robotgtfxry/10.525-GHz-Radar/(list of files, drawings)

Other design files:
kicad/kicad/temp-freerouting.dsn
kicad/mux/temp-freerouting.dsn
