robotgtfxry/10.525-GHz-Radar/kicad/kicad/kicad.kicad_pcb

## KiCad design kicad/kicad/kicad.kicad_pcb (2026-08-19)

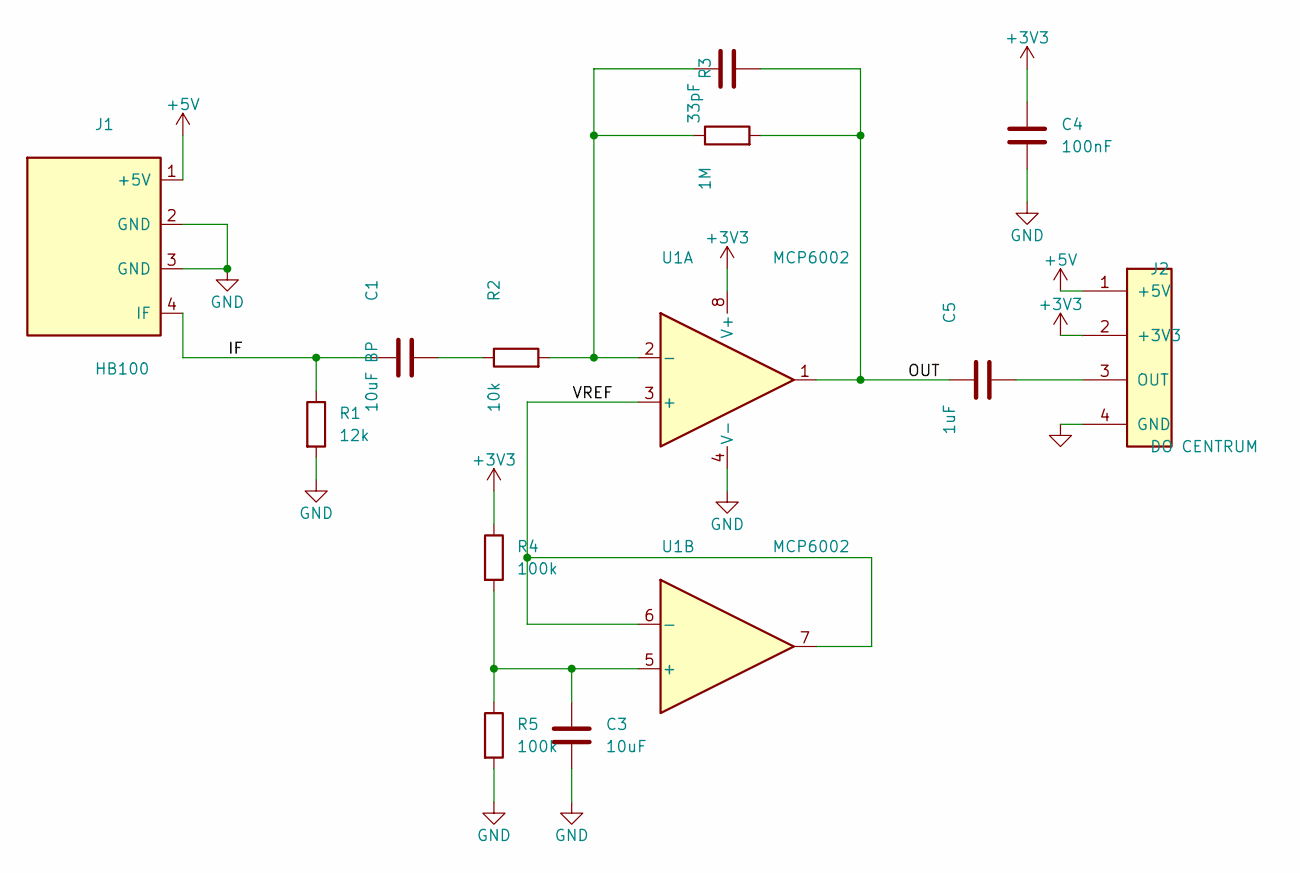
[picture p1: schematic kicad.kicad_sch]

Parts:
C1: 10uF BP; C_1210_3225Metric_Pad1.33x2.70mm_HandSolder
C2: 33pF; C_1206_3216Metric_Pad1.33x1.80mm_HandSolder
C3: 10uF; C_1210_3225Metric_Pad1.33x2.70mm_HandSolder
C4: 100nF; C_1206_3216Metric_Pad1.33x1.80mm_HandSolder
C5: 1uF; C_1206_3216Metric_Pad1.33x1.80mm_HandSolder
J1: HB100; HB100_Pads_4x_THT
J2: DO CENTRUM; JST_XH_B4B-XH-A_1x04_P2.50mm_Vertical
R1: 12k; R_1206_3216Metric_Pad1.30x1.75mm_HandSolder
R2: 10k; R_1206_3216Metric_Pad1.30x1.75mm_HandSolder
R3: 1M; R_1206_3216Metric_Pad1.30x1.75mm_HandSolder
R4, R5: 100k; R_1206_3216Metric_Pad1.30x1.75mm_HandSolder
U1: MCP6002; SOIC-8_3.9x4.9mm_P1.27mm

Connections:
+3V3: C4.1, J2.2 (+3V3), R4.1, U1.8 (V+)
+5V: J1.1 (+5V), J2.1 (+5V)
/IF: C1.1, J1.4 (IF), R1.1
/OUT: C2.2, C5.1, R3.2, U1.1
/VREF: U1.3 (+), U1.6 (-), U1.7
GND: C3.2, C4.2, J1.2 (GND), J1.3 (GND), J2.4 (GND), R1.2, R5.2, U1.4 (V-)
unnamed: C1.2, R2.1
unnamed: C5.2, J2.3 (OUT)
unnamed: C2.1, R2.2, R3.1, U1.2 (-)
unnamed: C3.1, R4.2, R5.1, U1.5 (+)

Board: 2 copper layers, 13 parts (0 on the bottom side), 10 nets, no tracks yet.
