robotgtfxry/10.525-GHz-Radar/kicad/mux/mux.kicad_pcb

## KiCad design kicad/mux/mux.kicad_pcb (2026-08-19)

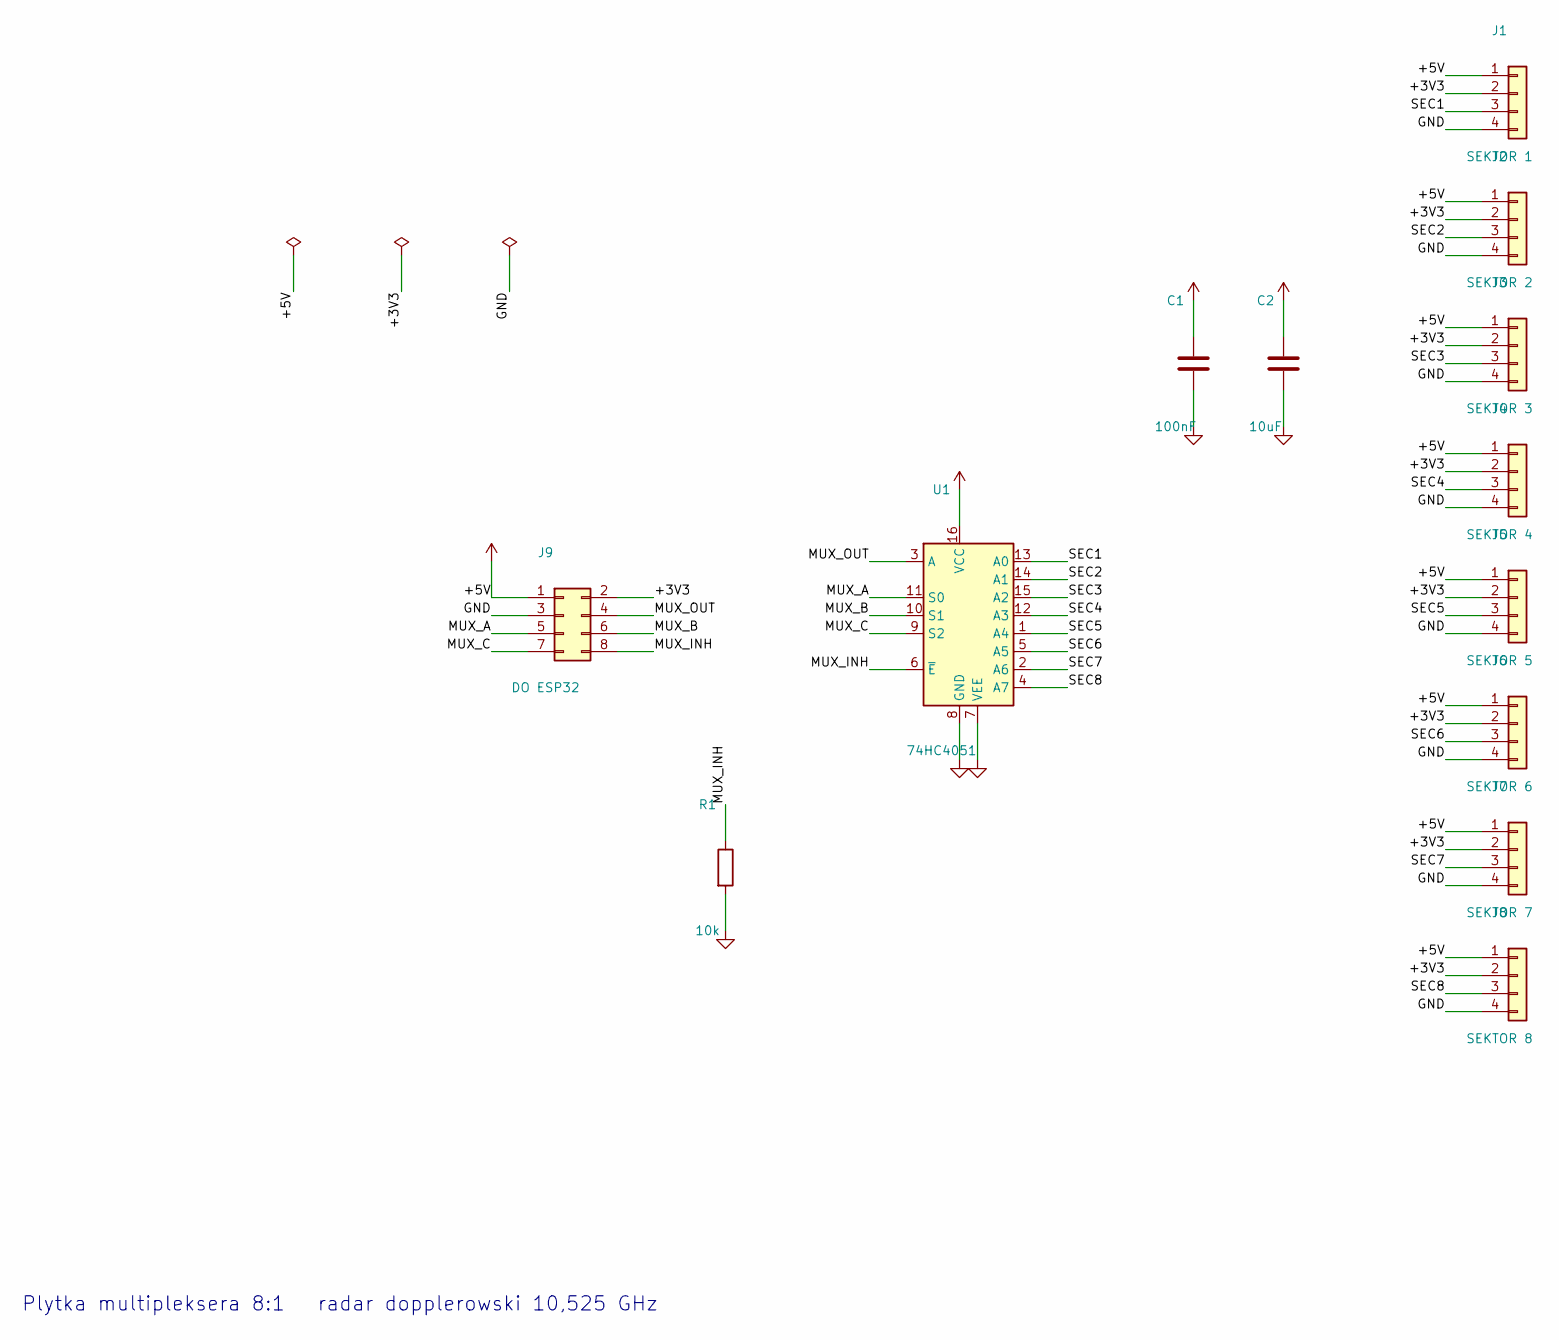
[picture p2: schematic mux.kicad_sch]

Parts:
C1: 100nF; C_1206_3216Metric_Pad1.33x1.80mm_HandSolder
C2: 10uF; C_1210_3225Metric_Pad1.33x2.70mm_HandSolder
J1: SEKTOR 1; JST_XH_B4B-XH-A_1x04_P2.50mm_Vertical
J2: SEKTOR 2; JST_XH_B4B-XH-A_1x04_P2.50mm_Vertical
J3: SEKTOR 3; JST_XH_B4B-XH-A_1x04_P2.50mm_Vertical
J4: SEKTOR 4; JST_XH_B4B-XH-A_1x04_P2.50mm_Vertical
J5: SEKTOR 5; JST_XH_B4B-XH-A_1x04_P2.50mm_Vertical
J6: SEKTOR 6; JST_XH_B4B-XH-A_1x04_P2.50mm_Vertical
J7: SEKTOR 7; JST_XH_B4B-XH-A_1x04_P2.50mm_Vertical
J8: SEKTOR 8; JST_XH_B4B-XH-A_1x04_P2.50mm_Vertical
J9: DO ESP32; PinHeader_2x04_P2.54mm_Vertical
R1: 10k; R_1206_3216Metric_Pad1.30x1.75mm_HandSolder
U1: 74HC4051; SOIC-16_3.9x9.9mm_P1.27mm

Connections:
+3V3: C1.1, C2.1, J1.2, J2.2, J3.2, J4.2, J5.2, J6.2, J7.2, J8.2, J9.2, U1.16 (VCC)
+5V: J1.1, J2.1, J3.1, J4.1, J5.1, J6.1, J7.1, J8.1, J9.1
/MUX_A: J9.5, U1.11 (S0)
/MUX_B: J9.6, U1.10 (S1)
/MUX_C: J9.7, U1.9 (S2)
/MUX_INH: J9.8, R1.1, U1.6 (~E)
/MUX_OUT: J9.4, U1.3 (A)
/SEC1: J1.3, U1.13 (A0)
/SEC2: J2.3, U1.14 (A1)
/SEC3: J3.3, U1.15 (A2)
/SEC4: J4.3, U1.12 (A3)
/SEC5: J5.3, U1.1 (A4)
/SEC6: J6.3, U1.5 (A5)
/SEC7: J7.3, U1.2 (A6)
/SEC8: J8.3, U1.4 (A7)
GND: C1.2, C2.2, J1.4, J2.4, J3.4, J4.4, J5.4, J6.4, J7.4, J8.4, J9.3, R1.2, U1.7 (VEE), U1.8 (GND)

Notes on the sheet:
Plytka multipleksera 8:1 radar dopplerowski 10,525 GHz

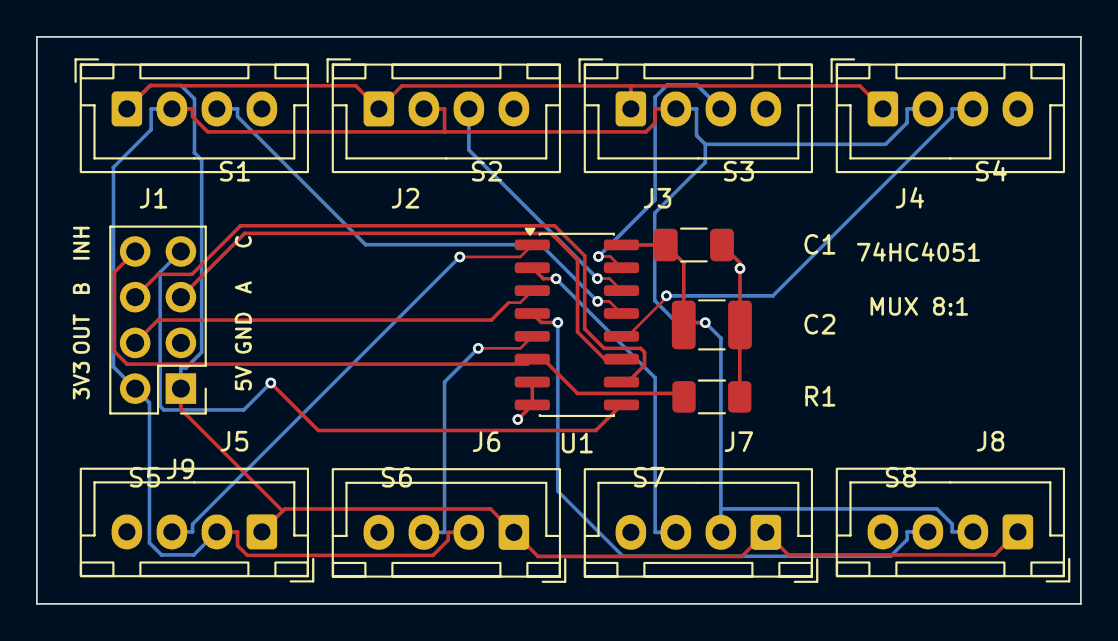
[picture p3: board mux.kicad_pcb from above]

Board: 2 copper layers, 58.0 x 31.5 mm, 13 parts (0 on the bottom side), 16 nets.
